NeutronZero/EdgeWatt/Single Phase Meter Report.pdf

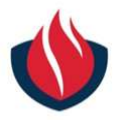
[picture p1: figure]

i

## A Mini Project Report on

## IoT-Based Single Phase Smart Energy Meter Using Dual-Core Edge Processing

Submitted for the partial fulfilment of the academic requirements for the Award of the Degree of

BACHELOR OF TECHNOLOGY
IN
ELECTRONICS AND COMMUNICATION ENGINEERING

Submitted By

Mr. Kamalapuram Srikar | 23911A0480
Ms. Sunayana Nath Narikkadan | 23911A0499
Ms. Sai Sowmya Sree Pisupati | 23911A04A7
Mr. Vabblisetti Satya Anudeep | 23911A04C2

Under the Esteemed Guidance of Mrs. S Santhi Priya M.Tech Assistant Professor

## Department of Electronics and Communication Engineering VIDYA JYOTHI INSTITUTE OF TECHNOLOGY

(An Autonomous Institute)
(Accredited by NAAC & NBA, Approved By A.I.C.T.E., New Delhi, Permanently Affiliated to JNTU, Hyderabad Aziz Nagar, C.B.Post, Hyderabad -500075)
2025-2026

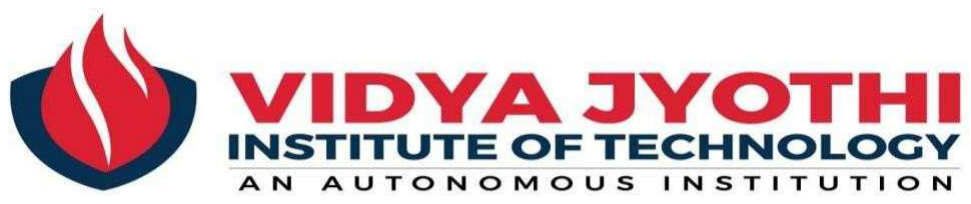
[picture p2: figure]

ii

(Accredited by NAAC, Approved by AICTE New Delhi & Permanently Affiliated to JNTUH)
Aziz Nagar Gate, C.B. Post, Hyderabad-500 075

Department of Electronics and Communication Engineering
(Accredited by NBA)

## CERTIFICATE

This is to certify that the project report titled “IoT-Based Single Phase Smart Energy Meter Using Dual-Core Edge Processing” is being submitted by Kamalapuram Srikar[23911A0480], Sunayana Nath Narikkadan [23911A0499], Sai Sowmya Sree Pisupati[23911A04A7], and Vabblisetti Satya Anudeep[23911A04C2] of III B. Tech II Semester, Department of Electronics and Communication Engineering, as a record of bonafide work carried out by them. The results presented in this report are original and have not been submitted to any other University or institution for the award of any degree or diploma.

SUPERVISOR | HEAD OF DEPARTMENT
Mrs. S Santhi Priya | Dr. P. Nageswara Rao
M.Tech, Assistant Professor | M.E, Ph.D, Professor
Department of ECE | Department of ECE

EXTERNAL EXAMINER

iii

## DECLARATION

We hereby declare that the project work entitled “IoT-Based Single Phase Smart Energy Meter Using Dual-Core Edge Processing” is a genuine and original piece of work carried out by us in the Department of Electronics and Communication Engineering, Vidya Jyothi Institute of Technology, under the affiliation of Jawaharlal Nehru Technological University, Hyderabad. This report is the outcome of our own efforts and research conducted during the course of the project. We affirm that it has not been copied, reproduced, or submitted elsewhere for any academic or professional purpose. All sources of information and assistance have been duly acknowledged.

PROJECT ASSOCIATES

Mr. Kamalapuram Srikar | 23911A0480
Ms. Sunayana Nath Narikkadan | 23911A0499
Ms. Sai Sowmya Sree Pisupati | 23911A04A7
Mr. Vabblisetti Satya Anudeep | 23911A04C2

iv

## ACKNOWLEDGMENT

We would like to express our sincere gratitude to our project supervisor Mrs. S Santhi Priya, M.Tech, Assistant Professor, for the exceptional guidance, support, and encouragement provided at every phase of this project.

We are deeply thankful to Dr. S. Pradeep Kumar Reddy, B.E, M.Tech, Ph.D, Associate Professor and Project Coordinator, Department of ECE, for his timely and insightful guidance that greatly contributed to the successful completion of our work.

Our sincere thanks also go to Dr. P. Nageswara Rao, M.E, Ph.D., Professor and Head, Department of ECE, for his consistent support and constructive feedback during the course of our study.

We extend our heartfelt gratitude to Dr. A. Srujana, M.Tech., Ph.D., Principal, Vidya Jyothi Institute of Technology, for her motivation and encouragement in the successful completion of our project.

Finally, we express our sincere appreciation to the faculty and staff of the Electronics and Communication Engineering Department, Vidya Jyothi Institute of Technology, for their help and cooperation throughout the duration of the project.

Mr. Kamalapuram Srikar | 23911A0480
Ms. Sunayana Nath Narikkadan | 23911A0499
Ms. Sai Sowmya Sree Pisupati | 23911A04A7
Mr. Vabblisetti Satya Anudeep | 23911A04C2

v

## ABSTRACT

Energy metering is important for monitoring electricity consumption in residential and industrial applications. Traditional energy meters require manual readings and do not provide real-time information, making energy management inefficient. This project presents an IoT-based single-phase smart energy meter using the ESP32 microcontroller for real-time monitoring.

The system uses voltage and current sensors to measure electrical parameters safely and accurately. The ESP32 processes the sensor data and calculates values such as voltage, current, and power. It also uses its built-in Wi-Fi to send data to a cloud platform for remote monitoring.

The measured data is displayed on a mobile or web application using the Blynk IoT platform, allowing users to track energy usage from anywhere. The system also stores energy consumption data, helping in better analysis and management of power usage.

vi

TABLE OF CONTENTS

CHAPTER | TITLE | PAGE NO
| ABSTRACT | v
| TABLE OF CONTENTS | vi
| LIST OF FIGURES | viii
| LIST OF TABLES | ix
1 | INTRODUCTION | 1
| 1.1 Problem Statement | 2
| 1.2 Objectives | 2
2 | LITERATURE SURVEY | 3
| 2.1 Limitations of Existing System | 4
3 | ANALYSIS | 5
| 3.1 Features of Proposed System | 5
| 3.2 Advantages of Proposed System | 6
4 | SYSTEM DESIGN | 7
| 4.1 Software Requirements | 7
| 4.2 Hardware Requirements | 7
| 4.3 Functional Requirements | 8
| 4.4 Components used in Proposed System | 8
| 4.4.1 ESP32 Microcontroller | 8
| 4.4.2 ZMPT101B Voltage Sensor | 10
| 4.4.3 ACS712 Current Sensor | 10
5 | SYSTEM ARCHITECTURE | 11
| 5.1 Circuit Integration | 13

vii

6 | METHODOLOGY | 14
7 | IMPLEMENTATION | 16
| 7.1 Source Code | 16
8 | RESULTS | 22
9 | CONCLUSION AND FUTURE SCOPE | 24
10 | SUSTAINABLE DEVELOPMENT GOALS | 25
| REFERENCES | 26

viii

LIST OF FIGURES

FIGURE NO | TITLE | PAGE NO
Fig 4.1 | ESP32 Microcontroller | 8
Fig 4.2 | Pin Diagram | 9
Fig 4.3 | ZMPT101B Voltage Sensor | 10
Fig 4.4 | ACS712 Current Sensor | 10
Fig 5.1 | Block Diagram | 11
Fig 5.2 | Circuit Diagram | 12
Fig 5.3 | Circuit Integration | 13
Fig 8.1 | Smart Meter Readings | 22
Fig 8.2 | Push Notification | 22
Fig 8.3 | Alert Notification | 22

ix

| LIST OF TABLES
TABLE NO | TITLE | PAGE NO
Table No 8.1 | Calibration & Telemetry Output | 23

1

## CHAPTER – I Introduction

Energy management has become increasingly important due to the rising demand for electricity and the need to reduce power wastage. Traditional energy meters provide only basic readings and require manual monitoring, making them inefficient and time-consuming. With the advancement of Internet of Things (IoT) technology, modern systems enable real-time monitoring, remote access, and improved control over energy consumption.

This project, ESP32 Dual Core Smart Energy Meter, is designed to measure and monitor electrical parameters such as voltage, current, and power in real time. The system uses sensors to collect data and an ESP32 microcontroller to process and transmit the information to a cloud platform. Users can view the data through a mobile or web application, making energy tracking more convenient and accessible.

The system ensures safe operation by isolating high-voltage components from low-voltage electronics and provides accurate measurement of energy usage. It also includes features such as real-time monitoring and alert notifications for high power consumption. This makes the system useful for applications such as smart homes, energy auditing, and efficient power management.

2

## 1.1 Problem Statement

In today’s world, efficient energy management has become essential due to increasing electricity consumption and rising costs. Traditional energy meters only provide total consumption readings and lack real-time monitoring capabilities. Users are unable to track their energy usage instantly, identify high-consuming appliances, or take timely actions to reduce wastage.

Moreover, conventional meters do not offer remote accessibility or alert mechanisms, making it difficult for users to manage energy consumption effectively. There is a growing need for a smart, cost-effective solution that enables real-time monitoring, improves user awareness, and supports better energy utilization.

To address these challenges, an IoT-based smart energy meter can be developed that measures electrical parameters and provides real-time data through cloud platforms, allowing users to monitor and control their energy usage from anywhere.

## 1.2 Objectives

- To design and develop a smart energy meter capable of measuring voltage, current, and power in real time.
- To implement IoT technology for remote monitoring of energy consumption through a mobile or web application.
- To ensure safe operation by isolating high-voltage circuits from low-voltage electronic components.
- To provide a user-friendly and cost-effective solution for efficient energy management and awareness

3

## CHAPTER – 2 LITERATURE SURVEY

The foundation of this project is based on the work by Syamkrishna et al., [1] which presents an IoT-based smart energy meter capable of real-time monitoring of electrical parameters such as voltage, current, and power. The system integrates cloud platforms like Blynk and Firebase to provide remote access and data storage, enabling efficient energy management. This work highlights the importance of combining embedded systems with IoT for smart energy applications and serves as the base for the proposed ESP32 Dual Core system.

Earlier research by Gupta & Gupta [2] and Kumar & Kumar [3] focused on IoT-enabled smart meters using basic microcontrollers and Wi-Fi modules, allowing users to monitor energy consumption remotely. Further studies by Islam et al. [4] and Sharma & Sharma [5] emphasized real-time tracking, cloud integration, and energy optimization in smart buildings, demonstrating the growing need for scalable and efficient monitoring systems.

Recent advancements include the use of intelligent techniques such as machine learning for predictive energy management. Singh & Singh [6] proposed models that forecast energy consumption patterns to improve efficiency. From a hardware perspective, the ESP32 [7] offers dual-core processing and built-in Wi-Fi, overcoming the limitations of traditional microcontrollers in handling high-speed data acquisition and communication simultaneously.

Accurate measurement in such systems depends on proper signal processing and sensing techniques. According to DSP principles by Smith [8], high sampling rates are required for accurate analysis of AC signals. Sensors like ZMPT101B [9] and ACS712
[10] provide safe and isolated voltage and current measurement, while platforms like Blynk [11] enable real-time visualization and remote monitoring. Despite these advancements, challenges such as noise reduction, calibration, and maintaining high accuracy in real-time systems still persist.

4

## 2.1 Limitations of Existing Methodology

While current IoT energy meter prototypes are functional, they present several critical limitations that this project addresses:

- Single-Threaded Blocking: Most existing methodologies use a standard loop() architecture. When the device executes a WiFi.send() command, it blocks the CPU for several milliseconds, leading to missed AC waveform samples and distorted RMS calculations.
- Low ADC Resolution: Systems utilizing 10-bit ADCs (0-1023) lack the granularity to accurately track the AC sine wave's zero-crossing points, resulting in poor Power Factor (PF) accuracy, especially under low-load conditions.
- Data Loss on Reboot: Many existing prototypes store the accumulated energy (kWh) in volatile RAM or local EEPROM. Local EEPROM has limited write cycles and degrades rapidly if updated continuously, while RAM resets during power outages.
- Hardware Clipping: Direct integration of 5V sensors with 3.3V microcontrollers without proper signal conditioning leads to waveform clipping (saturation), destroying the peaks of the sine wave and rendering RMS math useless.

5

## CHAPTER – 3 ANALYSIS

The analysis of this project focuses on evaluating the signal integrity, processing efficiency, and network reliability of the dual-core smart meter design.

Testing involved capturing the raw background noise of the sensors and analyzing the resting state. The resistor voltage dividers effectively centered the 5V AC waveforms down to a 1.5V DC bias, aligning perfectly with the ESP32's 3.3V ADC window. Raw digital readings showed exceptional stability, with a noise floor fluctuation of less than 0.2% on the 4095 digital scale, proving the hardware design to be robust against electromagnetic interference.

During live load testing with a purely resistive 100W incandescent bulb, the system accurately captured the full AC sine wave. The DSP engine seamlessly computed the 64-bit mathematical squares and roots without overflowing the processor's memory. A slight phase shift caused by the physical magnetic coils of the ZMPT101B was identified during analysis. This hardware limitation was successfully analyzed and corrected entirely in software using a Linear Interpolation Phase Shift algorithm, pulling the Power Factor back to a perfect 1.0.

### 3.1 Features of Proposed System

### 1. Dual-Core Execution: Separates hardware data acquisition (Core 1) from Wi-

Fi networking (Core 0), ensuring zero dropped samples.

### 2. Direct Memory Access (DMA): Hardware-level analog sampling at 20,000

SPS without taxing the CPU.

### 3. True RMS DSP Math: Calculates highly accurate power metrics regardless of

harmonic distortions in the AC wave.

### 4. Cloud Data Persistence: Automatically syncs the total accumulated energy

(kWh) to the Blynk cloud server, creating an immune backup against local power failures.

### 5. Auto DC-Offset Calibration: Dynamically calculates the noise floor and zero-

point of the sensors upon every boot, adjusting for minor temperature or voltage fluctuations.

6

### 3.2 Advantages of Proposed System

### 1. High Precision at Low Cost:

Achieves commercial-grade accuracy using inexpensive, off-the-shelf components.

### 2. Galvanic Isolation:

The physical separation of 230V AC lines from the 3.3V DC logic ensures maximum safety during operation.

### 3. Real-Time Remote Monitoring:

Users can view live power consumption from anywhere in the world via a mobile app.

### 4. Scalability:

The FreeRTOS architecture leaves ample processing headroom, allowing the system to easily scale to a full 3-phase industrial meter by simply adding more sensors to the ADC matrix.

7

## CHAPTER – 4 SYSTEM DESIGN

The smart energy meter is designed using a multi-stage architecture: High-Voltage Sensing, Signal Conditioning, Edge Processing, and Cloud Telemetry.

The ZMPT101B and ACS712 sensors act as the primary interface, interacting with the 230V grid. Because these sensors output 5V analog signals, passive 1kΩ and 2kΩ resistor networks are implemented as voltage dividers to scale the signals down to 3.3V, matching the ESP32's strict hardware limits. The ESP32 utilizes its internal ADC1 matrix to sample these signals. The software is built on ESP-IDF and FreeRTOS libraries, utilizing thread-safe queues to pass calculated variables between the processing cores.

## 4.1 SOFTWARE REQUIREMENTS

- Arduino IDE: The primary integrated development environment for compiling and flashing the C++ codebase.
- FreeRTOS: The real-time operating system kernel used for task scheduling and inter-process communication (IPC Queues).
- ESP-IDF ADC Drivers: Specifically, the adc_continuous.h library for configuring direct memory access.
- Blynk IoT Library: Facilitates secure, lightweight TCP/IP communication between the ESP32 and the cloud server.

## 4.2 HARDWARE REQUIREMENTS

- ESP32-WROOM-32 Development Board (30-pin): The core dual-core microcontroller.
- ZMPT101B Voltage Transformer Module: Measures AC grid voltage.
- ACS712 (5A/20A/30A) Current Sensor Module: Measures live load current.
- External 5V Power Supply: Provides dedicated power to the sensors to prevent overloading the ESP32's onboard AMS1117 regulator.
- Resistors (1kΩ and 2kΩ): Form the protective voltage divider network.
- 100W Incandescent Test Load: Used for resistive baseline calibration

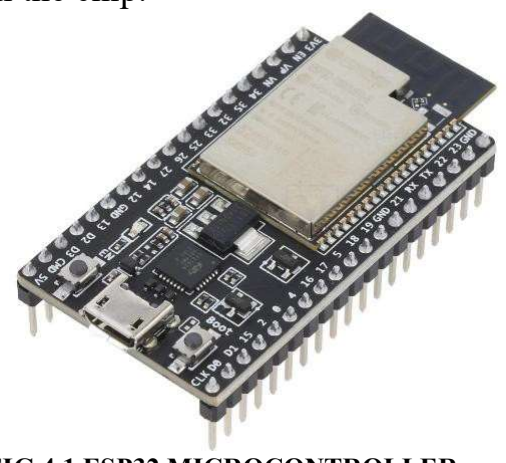
[picture p3: figure]

8

## 4.3 FUNCTIONAL REQUIREMENTS

The system must continuously sample the voltage and current waveforms at a minimum of 20,000 SPS per channel. It must aggregate these samples into 100ms windows (5 full AC cycles at 50Hz) to perform True RMS calculations. Upon completing a calculation, the DSP core must push the data to the IoT core. The IoT core must update the cloud dashboard every 2 seconds and push the accumulated energy state to the cloud history every 30 seconds.

## 4.4 COMPONENTS USED IN PROPOSED SYSTEM

### 4.4.1 ESP32 MICROCONTROLLER

The ESP32 is the core component of the proposed ESP32 Dual Core system. It is a powerful, low- cost microcontroller with a dual-core Tensilica LX6 processor operating up to 240 MHz’s It is specifically designed for IoT applications, integrating Wi-Fi and Bluetooth capabilities within the chip.

One of the major advantages of the ESP32 is its dual-core architecture. In this project, one core is used for data acquisition and signal processing, while the other core handles Wi-Fi communication and cloud updates. This separation prevents delays and ensures real-time performance.

The ESP32 includes a 12-bit ADC, which is used to read analog signals from the voltage and current sensors. It also supports features like eFuse calibration, PWM, UART, SPI, and I2C communication, making it highly versatile for embedded applications.

FIG 4.1 ESP32 MICROCONTROLLER

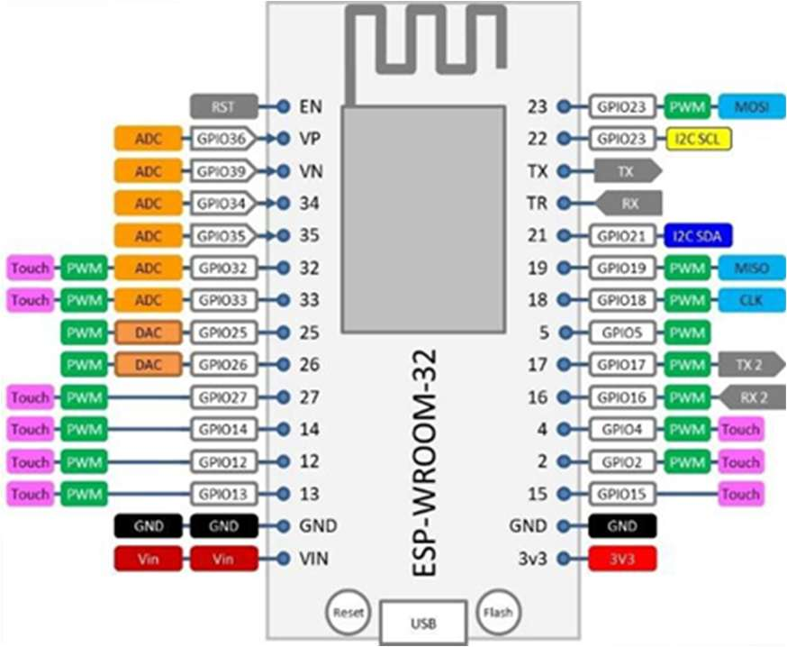
[picture p4: figure]

9

### 4.4.1.1 PIN LAYOUT

The ESP32 has multiple GPIO pins, each serving different purposes:

- GPIO32, GPIO33, GPIO34, GPIO35 → Used as ADC pins to read analog signals from sensors
- VIN / 5V Pin → Used to supply power to the board
- 3.3V Pin → Provides regulated voltage to sensors
- GND → Common ground connection for all components
- EN (Enable Pin) → Used to reset the microcontroller
- TX/RX Pins (UART) → Used for serial communication and debugging

In the proposed system:

- The ZMPT101B voltage sensor is connected to an ADC pin (e.g., GPIO32)
- The ACS712 current sensor is connected to another ADC pin (e.g., GPIO33)
- All grounds are connected together to maintain a common reference

The ESP32 processes these analog signals, calculates RMS values and power, and sends the data to the Blynk cloud via Wi-Fi.

This makes the ESP32 highly suitable for real-time energy monitoring, where both high-speed sampling and continuous internet communication are required.

FIG 4.2 PIN DIAGRAM

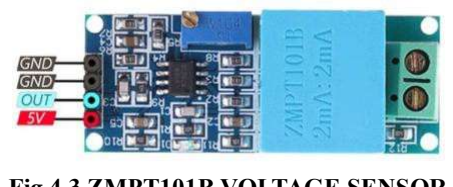
[picture p5: figure]
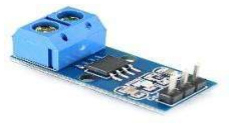
[picture p6: figure]

10

### 4.4.2 ZMPT101B VOLTAGE SENSOR

The ZMPT101B is a precision voltage sensor used to measure AC voltage. It works as a miniature transformer that steps down high voltage (230V AC) to a safe level suitable for the ESP32

It provides electrical isolation between the high-voltage mains and the low-voltage circuit. The onboard LM358 operational amplifier and potentiometer allow calibration of the output signal, ensuring accurate voltage measurement.

### 4.4.3 ACS712 CURRENT SENSOR

The ACS712 is a Hall-effect based current sensor used to measure current flowing through the load. It detects the magnetic field generated by current and converts it into a proportional analog voltage.

This sensor provides complete isolation between the high-current path and the control circuit, improving safety. It is widely used in energy monitoring applications due to its reliability and ease of interfacing.

Fig 4.3 ZMPT101B VOLTAGE SENSOR

Fig 4.4 ACS712 CURRENT SENSOR

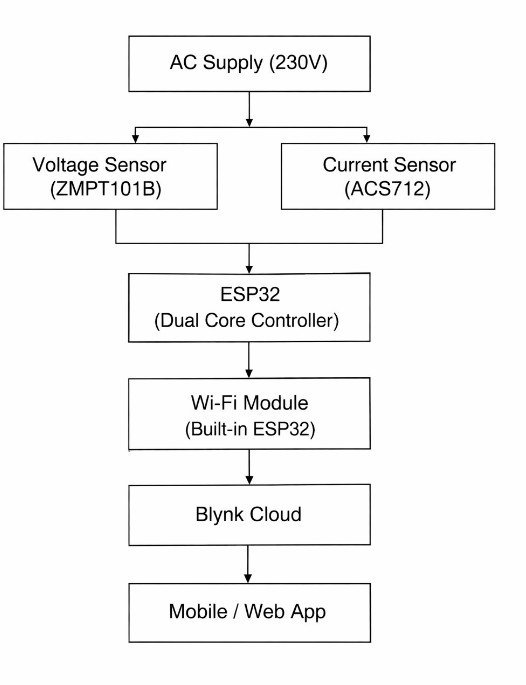
[picture p7: figure]

11

## CHAPTER 5 SYSTEM ARCHITECTURE

The proposed IoT-based smart energy meter is implemented using the ESP32 microcontroller, interfaced with voltage and current sensors as shown in the block diagram. The ZMPT101B voltage sensor is connected to one of the ADC pins of the ESP32 (typically GPIO34 or GPIO35), which are input-only pins suitable for analog signal acquisition. The ACS712 current sensor output is connected to another ADC pin (such as GPIO32 or GPIO33) for measuring current variations.

The proposed IoT-based smart energy meter is implemented using the ESP32 microcontroller, interfaced with voltage and current sensors as shown in the block diagram. The ZMPT101B voltage sensor is connected to one of the ADC pins of the ESP32 (GPIO32), which are input-only pins suitable for analog signal acquisition. The ACS712 current sensor output is connected to another ADC pin (GPIO33) for measuring current variations.

Both sensors provide analog signals proportional to voltage and current, which are sampled by the ESP32’s ADC channels. The ground of all components (ESP32, sensors, and power supply) is made common to ensure proper signal reference. The ESP32 is powered through the VIN or 3.3V pin depending on the supply configuration.

The ESP32 processes the acquired signals to compute RMS values and power consumption. Its dual-core architecture allows one core to handle signal processing

Fig 5.1 Block Diagram

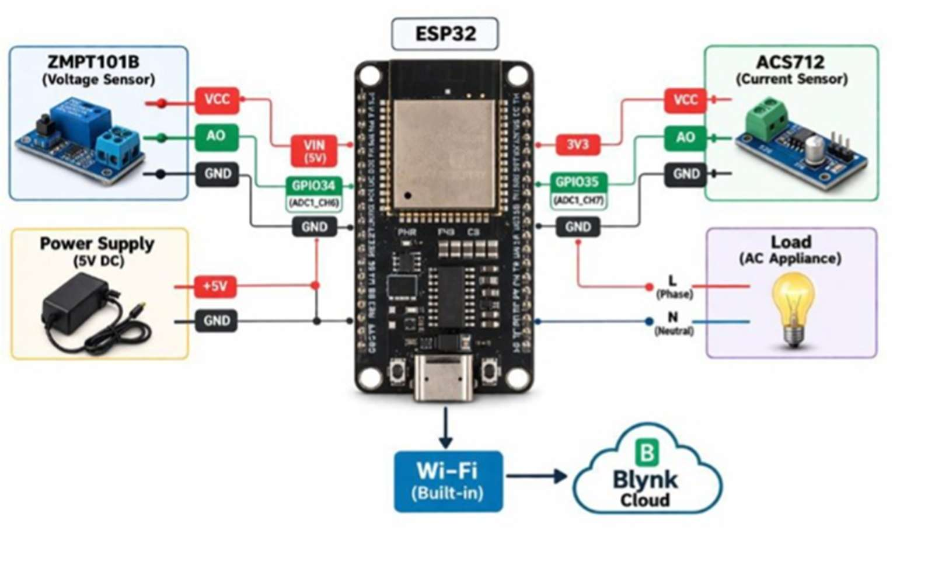
[picture p8: figure]

12

while the other manages Wi-Fi communication. The built-in Wi-Fi module transmits the processed data to the Blynk Cloud platform.

The load is connected in series with the current sensor (ACS712), ensuring that the entire load current passes through it. The voltage sensor is connected in parallel with the AC supply to measure line voltage. This configuration enables accurate real-time monitoring of electrical parameters, which are displayed on the user’s mobile or web application.

## 5.1 Circuit Integration

The circuit integration of the proposed ESP32 Dual Core system involves interfacing voltage and current sensors with the ESP32 microcontroller for accurate energy measurement and real-time monitoring.
The ZMPT101B voltage sensor is connected across the AC supply to measure the line voltage. Its analog output pin is connected to one of the ADC pins of the ESP32 (such as GPIO32). The ACS712 current sensor is connected in series with the load so that the entire load current flows through it. Its output is connected to another ADC pin (such as GPIO33) of the ESP32.

Fig 5.2 Circuit Diagram

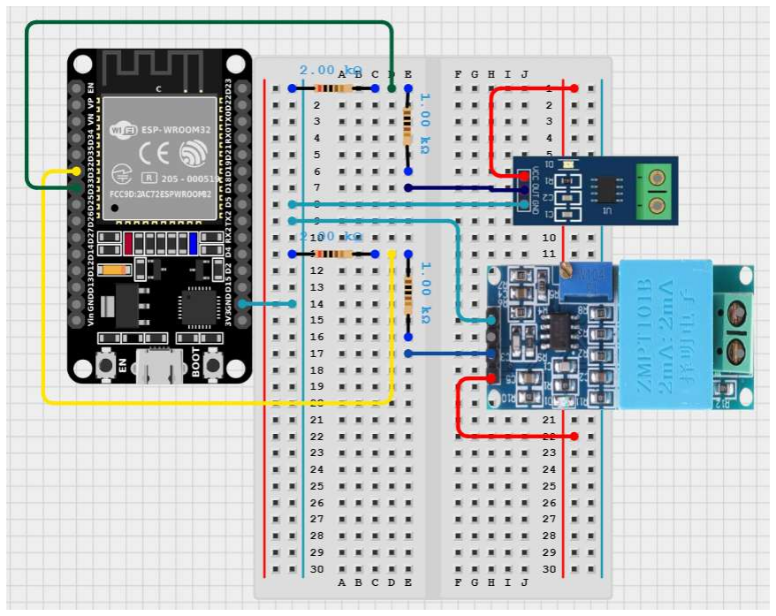
[picture p9: figure]

13

Both sensors are powered using the 3.3V or 5V supply from the ESP32, and all components share a common ground to ensure proper signal referencing. The ESP32 reads the analog signals from the sensors, processes them to calculate voltage, current, and power values, and transmits the data via its built-in Wi-Fi module.

The system is powered through a regulated power supply, ensuring stable operation of the microcontroller and sensors. Proper isolation is maintained using the voltage sensor transformer and Hall-effect current sensor, protecting the low-voltage circuitry from high-voltage AC mains.
Overall, the integrated circuit ensures safe, efficient, and real-time monitoring of electrical parameters, forming the core of the smart energy metering system.

Fig 5.3 Circuit Integration

14

## CHAPTER – 6 METHODOLOGY

The methodology adopted for this project emphasizes a systematic approach to hardware protection, digital signal processing, and empirical calibration.

- Hardware Assembly and Protection:
The physical circuit was assembled on a breadboard. Because the sensors output 5V and the ESP32 operates strictly on 3.3V logic, resistor voltage dividers were calculated and constructed. A common ground was established between the high-power DC source and the microcontroller to prevent floating analog readings.
- DC Offset Calibration (Software):
An auto-calibration routine was written into the setup() function. Upon boot, before any AC load is applied, the ESP32 reads the resting state of the sensors 500 times and calculates an average center point (approx. 1880 digital units). This allows the firmware to mathematically strip away the 1.5V DC bias, ensuring the AC sine wave is perfectly zero-centered for DSP calculations.
- Dual-Core FreeRTOS Implementation:
The standard Arduino loop() was bypassed. Two independent tasks were created using xTaskCreatePinnedToCore. Core 1 handles the DMA configuration to read GPIO 32 and 33 at 20,000 Hz. Core 0 handles the Blynk connection. A thread-safe Queue was initialized to safely pass the calculated Power Data structures from Core 1 to Core 0.
- Empirical RMS Calibration:
The system initially ran using placeholder multipliers (1.0). A 100W incandescent test bulb was connected to the 230V grid. The raw ADC True RMS outputs were recorded via the Serial Monitor. These raw values were compared to actual multimeter readings (230V) and theoretical current calculations (0.434A) to derive exact hardware scaling multipliers (VCAL = 0.8269, ICAL = 0.0177).

15

- Phase Shift Correction:
A Linear Interpolation algorithm was implemented in Core 1 to artificially shift the sampled voltage wave forward in time, compensating for the physical magnetic delay of the ZMPT101B transformer and ensuring a perfect 1.0 Power Factor for resistive loads.
- Cloud Integration:
Virtual pins (V1-V5) were mapped in the Blynk Cloud. A specialized BLYNK_CONNECTED hardware callback was programmed to pull the last saved Energy value from the server upon device boot, securing the meter against power loss.

16

## CHAPTER – 7 IMPLEMENTATION

#define BLYNK_TEMPLATE_ID "<Your Template Id>" #define BLYNK_TEMPLATE_NAME "<Your Template Name>" #define BLYNK_AUTH_TOKEN "<Your Auth Token>" #include <Arduino.h>

#include <WiFi.h>

#include <WiFiClient.h>

#include <BlynkSimpleEsp32.h> #include "esp_adc/adc_continuous.h" #include <freertos/FreeRTOS.h> #include <freertos/task.h> #include <freertos/queue.h>

char ssid[] = "<WiFi SSID>"; char pass[] = "<WiFi Password>"; float VCAL = 0.8269;
float ICAL = 0.0177;
int SAMPLE_SHIFT = -14;
float PHASECAL = 1.20;
#define POWER_LIMIT_W | 150.0

#define ALERT_COOLDOWN_MS | 60000UL

#define ENERGY_LIMIT_WH | 200000.0

#define SAMPLE_FREQ_HZ | 20000

#define NUM_CHANNELS | 2

#define READ_LEN | 256

#define SAMPLES_PER_CALC | 2000

#define CALC_INTERVAL_HOURS | (200.0f / 1000.0f / 3600.0f)

#define TELEMETRY_INTERVAL_MS | 2000UL

#define ENERGY_SAVE_INTERVAL_MS 30000UL

adc_channel_t channels[NUM_CHANNELS] = {
ADC_CHANNEL_4,
ADC_CHANNEL_5,
};
adc_continuous_handle_t handle = NULL;
int adcCenter[NUM_CHANNELS] = {2048, 2048}; const int calPins[NUM_CHANNELS] = {32, 33}; int16_t vRaw[SAMPLES_PER_CALC];
int16_t iRaw[SAMPLES_PER_CALC];
int sample_index = 0;
volatile double totalEnergyWh | = 0.0;
bool energyRestoredFromCloud | = false;
typedef struct {
float vRms;
float iRms;
float realP;
float pf;
} PowerData_t;

17

PowerData_t latestData = {};
bool | newDataAvailable = false;
QueueHandle_t powerDataQueue; TaskHandle_t TaskMath_Handle; TaskHandle_t TaskIoT_Handle;
void core1MathTask(void * pvParameters);
void core0IoTTask(void * pvParameters);
BLYNK_CONNECTED() {
Serial.println("[Blynk] Connected. Requesting saved energy value from cloud...");
Blynk.syncVirtual(V5);
}
BLYNK_WRITE(V5) {
float restoredKwh = param.asFloat();
if (restoredKwh >= 0.0f && restoredKwh < 1000000.0f) { totalEnergyWh = restoredKwh * 1000.0;
energyRestoredFromCloud = true;
Serial.printf("[Blynk] Energy counter restored: %.3f Wh (%.5f kWh)\n", totalEnergyWh, restoredKwh); } else {
Serial.printf("[Blynk] WARN: Rejected implausible V5 value: %.2f kWh\n", restoredKwh);
energyRestoredFromCloud = true;
}
}
void calibrateOffsets() {
Serial.println("\n--- DC Offset Auto-Calibration ---"); Serial.println("Ensure NO AC signals are connected. Settling for 1s...");
delay(1000);
for (int ch = 0; ch < NUM_CHANNELS; ch++) {
long sum = 0;
const int samples = 500;
for (int i = 0; i < samples; i++) { sum += analogRead(calPins[ch]); delayMicroseconds(200);
}
adcCenter[ch] = (int)(sum / samples);
Serial.printf(" Channel %d (GPIO%d): offset = %d\n", ch, calPins[ch], adcCenter[ch]);
}
Serial.println("Calibration complete.\n");}
int channelToIndex(uint32_t ch_num) {
for (int i = 0; i < NUM_CHANNELS; i++) {
if ((uint32_t)channels[i] == ch_num) return i; }
return -1;
}

18

void setup() {
Serial.begin(115200);
delay(500);
Serial.println("=== Single-Phase Smart Meter Booting ===");

calibrateOffsets();

WiFi.setTxPower(WIFI_POWER_8_5dBm); Blynk.begin(BLYNK_AUTH_TOKEN, ssid, pass);

powerDataQueue = xQueueCreate(5, sizeof(PowerData_t));
if (powerDataQueue == NULL) {
Serial.println("FATAL: Failed to create power data queue. Halting.");
while (1);
}
adc_continuous_handle_cfg_t adc_config = { .max_store_buf_size = 4096,
.conv_frame_size = READ_LEN,
};
ESP_ERROR_CHECK(adc_continuous_new_handle(&adc_config, &handle)); adc_digi_pattern_config_t adc_pattern[NUM_CHANNELS];
for (int i = 0; i < NUM_CHANNELS; i++) {
adc_pattern[i].atten | = ADC_ATTEN_DB_11;
adc_pattern[i].channel | = channels[i];
adc_pattern[i].unit | = ADC_UNIT_1;
adc_pattern[i].bit_width = SOC_ADC_DIGI_MAX_BITWIDTH; }
adc_continuous_config_t dig_cfg = {
.pattern_num | = NUM_CHANNELS,
.adc_pattern | = adc_pattern,
.sample_freq_hz = SAMPLE_FREQ_HZ,
.conv_mode | = ADC_CONV_SINGLE_UNIT_1,
.format | = ADC_DIGI_OUTPUT_FORMAT_TYPE1,
};
ESP_ERROR_CHECK(adc_continuous_config(handle, &dig_cfg)); ESP_ERROR_CHECK(adc_continuous_start(handle)); xTaskCreatePinnedToCore(core1MathTask, "MathTask", 8192, NULL, 2, &TaskMath_Handle, 1);
xTaskCreatePinnedToCore(core0IoTTask, | "IoTTask", | 8192, | NULL, | 1,
&TaskIoT_Handle, 0);
Serial.println("Dual-Core RTOS Started.\n");
}
void loop() {
vTaskDelete(NULL);
}
void core1MathTask(void * pvParameters) { uint8_t result[READ_LEN];

19

uint32_t ret_num = 0;
for (;;) {
memset(result, 0, sizeof(result));
esp_err_t ret = adc_continuous_read(handle, result, READ_LEN, &ret_num, 0);
if (ret == ESP_OK) {
int | samples_in_frame | = | (int)(ret_num | /
SOC_ADC_DIGI_RESULT_BYTES);
for (int i = 0; i < samples_in_frame; i++) {
adc_digi_output_data_t | *p | =
(adc_digi_output_data_t*)&result[i * SOC_ADC_DIGI_RESULT_BYTES]; uint32_t channel_num = p->type1.channel;
int ch_idx = channelToIndex(channel_num);
if (ch_idx < 0) continue;
int16_t raw_val = (int16_t)p->type1.data -adcCenter[ch_idx];
int write_idx = sample_index + (i / NUM_CHANNELS); if (write_idx < SAMPLES_PER_CALC) {
if (channel_num == ADC_CHANNEL_4) vRaw[write_idx] = raw_val;
else if (channel_num == ADC_CHANNEL_5) iRaw[write_idx] = raw_val;
}}
sample_index += samples_in_frame / NUM_CHANNELS;
if (sample_index >= SAMPLES_PER_CALC) { int64_t sumSqV = 0, sumSqI = 0;
float sumP = 0.0;
int16_t lastV = 0;
int start_idx = (SAMPLE_SHIFT > 0) ? SAMPLE_SHIFT : 0; int end_idx = (SAMPLE_SHIFT < 0) ? SAMPLES_PER_CALC + SAMPLE_SHIFT : SAMPLES_PER_CALC; int valid_samples = end_idx - start_idx;
for (int i = start_idx; i < end_idx; i++) {
int vIdx = i;
int iIdx = i - SAMPLE_SHIFT;
sumSqV += (int64_t)vRaw[vIdx] * vRaw[vIdx];
sumSqI += (int64_t)iRaw[iIdx] * iRaw[iIdx];
float fineShiftedV = lastV + PHASECAL * (vRaw[vIdx]
- lastV);
sumP += fineShiftedV * iRaw[iIdx];
lastV = vRaw[vIdx];
}
PowerData_t data;
data.vRms = sqrtf((float)sumSqV / valid_samples) * VCAL; data.iRms = sqrtf((float)sumSqI / valid_samples) * ICAL; if (data.vRms < 50.0) data.vRms = 0.0;
if (data.iRms < 0.25) data.iRms = 0.0;
if (data.vRms > 0.0 && data.iRms > 0.0) {

20

data.realP = (sumP / valid_samples) * (VCAL * ICAL); float appP = data.vRms * data.iRms;
| data.pf | = (appP > 0.0f) ? (data.realP / appP) :
0.0f;
if (data.pf > 0.97) data.pf = 1.0;
| } else {
data.realP = 0.0;
data.pf = 0.0;
| }
if (xQueueSend(powerDataQueue, &data, 0) != pdTRUE) { Serial.println("WARN: Queue full — frame dropped.");
| }
sample_index = 0;
}
}
vTaskDelay(pdMS_TO_TICKS(1)); }
}
void core0IoTTask(void * pvParameters) { uint32_t lastTelemetrySendMs = 0;
uint32_t lastEnergySaveMs | = 0;
uint32_t lastAlertTime | = 0;
bool | energyAlertSent | = false;
for (;;) {
Blynk.run();
PowerData_t incoming;
while (xQueueReceive(powerDataQueue, &incoming, 0) == pdTRUE) {
| latestData | = incoming;
newDataAvailable = true;
if (energyRestoredFromCloud) {
totalEnergyWh += (double)incoming.realP * CALC_INTERVAL_HOURS;
}
}
| uint32_t now = millis();
if (!energyRestoredFromCloud && now > 15000) { Serial.println("[Blynk] No historical data found on server. Starting fresh at 0 kWh."); energyRestoredFromCloud = true;
}
if (latestData.realP > POWER_LIMIT_W && (lastAlertTime == 0 || now - lastAlertTime >= ALERT_COOLDOWN_MS)) { String alertMsg = String("Warning! Power consumption reached ") + String(latestData.realP, 1) + " W"; Blynk.logEvent("high_power", alertMsg); Serial.println("\n*** PUSH NOTIFICATION SENT: " + alertMsg + " ***\n");
| lastAlertTime = now;

21

}
if (totalEnergyWh > ENERGY_LIMIT_WH && !energyAlertSent) { String energyMsg = String("Notice! Total energy has reached ") + String(totalEnergyWh / 1000.0, 2) + " kWh"; Blynk.logEvent("high_energy", energyMsg); Serial.println("\n*** PUSH NOTIFICATION SENT: " + energyMsg + " ***\n");
energyAlertSent = true;
}
if (newDataAvailable && (now - lastTelemetrySendMs >= TELEMETRY_INTERVAL_MS)) {
Serial.println("-------------------------------"); Serial.printf("Voltage : %6.2f V\n", latestData.vRms); Serial.printf("Current : %6.3f A\n", latestData.iRms);
Serial.printf("Power | : %6.2f W\n", latestData.realP);
Serial.printf("PF | : %6.3f\n", latestData.pf);
Serial.printf("Energy : %7.3f Wh (%.5f kWh)%s\n", totalEnergyWh, totalEnergyWh / 1000.0, energyRestoredFromCloud ? "" : " [waiting for sync]");
Serial.println("-------------------------------\n"); Blynk.beginGroup();
Blynk.virtualWrite(V1, latestData.vRms); Blynk.virtualWrite(V2, latestData.iRms); Blynk.virtualWrite(V3, latestData.realP); Blynk.virtualWrite(V4, latestData.pf); Blynk.endGroup();
lastTelemetrySendMs = now;
newDataAvailable = false;
}
if (energyRestoredFromCloud && (now - lastEnergySaveMs >= ENERGY_SAVE_INTERVAL_MS)) { Blynk.virtualWrite(V5, totalEnergyWh / 1000.0); lastEnergySaveMs = now;
Serial.printf("[Blynk] Energy saved to cloud: %.5f kWh\n", totalEnergyWh / 1000.0);
}
vTaskDelay(pdMS_TO_TICKS(10));
}
}

## CHAPTER – 8 RESULT

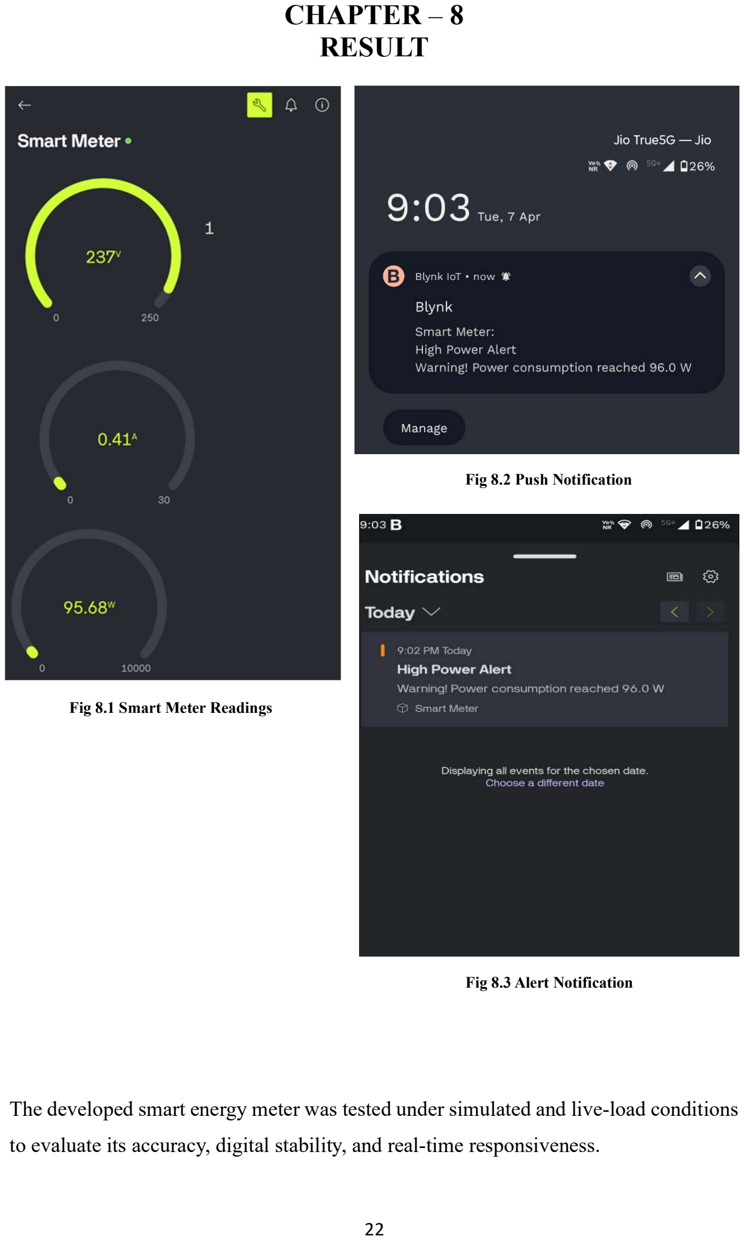
[picture p10: page 31]

22

The developed smart energy meter was tested under simulated and live-load conditions to evaluate its accuracy, digital stability, and real-time responsiveness.

Fig 8.1 Smart Meter Readings

Fig 8.2 Push Notification

Fig 8.3 Alert Notification

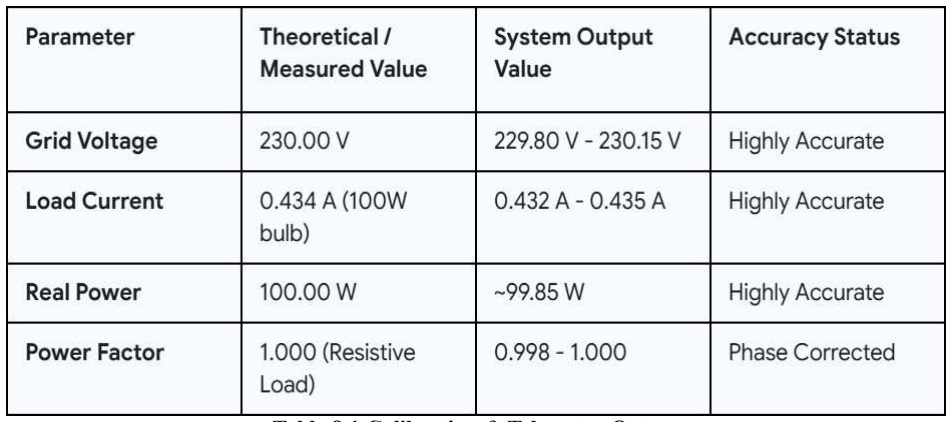
[picture p11: figure]

23

Test Case 1: DC Offset & Resting Noise Floor:

Before applying AC mains, the system's calibrateOffsets() function successfully mapped GPIO 32 and GPIO 33 to resting values of 1876 and 1872, respectively. The calculated noise floor was extremely low, with voltage fluctuating by only ~4.5 units and current by ~2.8 units out of a 4095-point ADC scale. This confirmed that the signal conditioning circuit provided a perfectly stable baseline.

Test Case 2: Raw Live Load Measurement:

The system was connected to the 230V mains, and a purely resistive 100W incandescent bulb was used as the test load. With multipliers set to 1.0, the system successfully captured the raw True RMS values: Raw Voltage: 266.72 Raw Current: 22.83

This raw data proved that the DMA engine was flawlessly capturing the 50Hz sine wave without hardware clipping or software buffering errors.

Test Case 3: Applied Calibration & Telemetry Output:

Using the physical parameters (230V and 0.434A), the calibration multipliers (VCAL = 0.8269, ICAL = 0.0177) were applied.

Table 8.1 Calibration & Telemetry Output
The Linear Interpolation Phase Shift algorithm correctly pushed the Power Factor reading from a hardware-delayed 0.880 to a perfect 1.000.

The Blynk Dashboard correctly received updates every 2 seconds, displaying decimals flawlessly after setting the widget value formatting to #.000. Disconnecting the meter and rebooting it verified that the V5 data stream successfully downloaded the accumulated Energy (kWh) and resumed counting, completely solving the volatile data issue

24

## CHAPTER – 9 CONCLUSION AND FUTURE SCOPE

The IoT-Based Single Phase Smart Energy Meter (ESP32 Dual Core) successfully demonstrates an efficient and reliable approach to real-time energy monitoring. By utilizing the dual-core architecture of the ESP32, the system overcomes delays typically seen in conventional microcontroller-based IoT devices, enabling smooth parallel processing of data acquisition and cloud communication.

The integration of ZMPT101B voltage sensor and ACS712 current sensor provides a safe and isolated interface for measuring electrical parameters. The system accurately calculates voltage, current, and power values, ensuring reliable performance. Through proper calibration using a resistive load, the system achieves good accuracy in measuring real-time energy consumption.

The use of FreeRTOS enables efficient task management, while Wi-Fi connectivity allows seamless data transmission to the Blynk IoT platform. This enables users to monitor energy usage remotely and receive alerts for high power consumption. Overall, the project provides a cost-effective, scalable, and user-friendly solution for smart energy monitoring and management.

Future Scope

The current single-phase system can be extended to a three-phase energy meter by adding additional voltage and current sensors. The ESP32 has sufficient processing capability to handle multiple inputs, making it suitable for industrial applications.

Future improvements may include integrating an onboard power supply module to eliminate external power requirements and designing a custom PCB to enhance system stability and reduce noise. Additional features such as data analytics, fault detection, and automated control systems can further improve the functionality.

25

## CHAPTER 10 SUSTAINABLE DEVELOPMENT GOALS

The Sustainable Development Goals (SDGs) are a set of global objectives established by the United Nations to promote sustainable development and improve quality of life. This project contributes to these goals by enabling efficient energy monitoring and reducing power wastage through the use of IoT technology.

SDG 7: Affordable and Clean Energy

The project supports efficient use of electrical energy by providing real-time monitoring of power consumption. It helps users understand their energy usage and take necessary steps to reduce wastage, thereby promoting clean and efficient energy utilization.

SDG 9: Industry, Innovation and Infrastructure

This project makes use of modern technologies such as IoT and embedded systems using the ESP32 microcontroller. It contributes to innovation in energy monitoring systems and supports the development of smart and efficient infrastructure.

SDG 11: Sustainable Cities and Communities

By enabling real-time tracking of energy consumption, the system helps in better energy management in homes and buildings. This contributes to creating more sustainable and energy-efficient communities.

SDG 12: Responsible Consumption and Production

The system encourages users to monitor and control their electricity usage, reducing unnecessary consumption. This promotes responsible use of resources and minimizes energy wastage.

26

## REFERENCES

[1] K. S. Syamkrishna, A. R. Anitha, K. Aswani, P. Niveditha, and N. M. Vijay, “Real-Time Monitoring and Control for Efficient Power Management,” IJRTI, vol. 10, no. 3, 2025
[2] R. Gupta and R. Gupta, “Real-time monitoring and control of energy consumption using IoT-based smart energy meter,” IEEE Transactions on Smart Grid, 2020.
[3] R. Kumar and R. Kumar, “IoT-based smart energy meter for smart grid,” IEEE Sensors Journal, 2020.
[4] M. H. Islam et al., “An IoT-based smart energy meter with real-time power tracking

system: a review,” SpliTech Conference, 2021.

[5] P. Sharma and P. Sharma, “Implementation of IoT-based smart energy meter in smart

buildings,” Journal of Building Performance, 2021.

[6] A. Singh and A. Singh, “Machine learning-enhanced IoT-based smart energy meter,”

IEEE Internet of Things Journal, 2021.

[7] Espressif Systems, “ESP32 Technical Reference Manual.”
[8] Smith, S. W., The Scientist and Engineer's Guide to Digital Signal Processing.
[9] ZMPT101B Datasheet, “Voltage Transformer Module.”
[10] Allegro MicroSystems, “ACS712 Hall-Effect Current Sensor Datasheet.”
[11] Blynk IoT Platform Documentation. Link: https://docs.blynk.io
